strawlab/lagtest-old/README.md

lagtest - How slow is your display?
===================================

This is the source code repository for the
[lagtest](http://lagtest.org) project. The desktop app is in `app/`,
the firmware for the Arduino-based device in in `lagtestino/`, and the
website is in `website/`.
