strawlab/lagtest-old/website/index.md

---
title: home
layout: default
---

# lagtest - How slow is your display?

<table><tr><td>
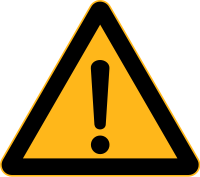
[picture p3: website/assets/img/warning.png]

</td><td>
Warning: lagtest.org is not yet complete, but we're developing in
public. To see our work in progress, check <a href="https://github.com/strawlab/lagtest">our github
repository</a>.
</td></tr></table>

## New displays are slow

Old-style CRT displays may be big and bulky, but there is practically
zero delay between video card output and luminance change on the
screen -- the analog voltages output by the video card directly
control the intensity of the electron beam. With the rise of new
display technologies such as LCDs and DLPs, this has changed for
several reasons (resampling the image and other onboard image
processing, inherent slowness due to the physics of the device, and so
on). The purpose of [lagtest.org](http://lagtest.org) is to let you
measure the latency from a computer program sending a draw command to
the result appearing on your screen.

<table>
  <tr><td align="center">
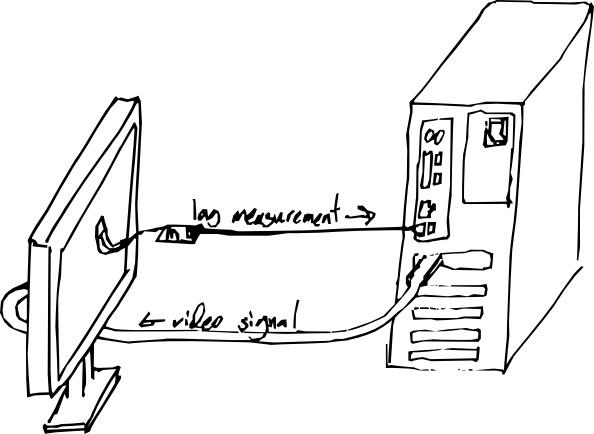
[picture p4: website/assets/img/lag-drawing.png]
    
  </td></tr>
  <tr><td>
    <strong>A simple USB device (based on an <a href="http://www.arduino.cc/">Arduino</a> and a
    photodiode) lets you measure latency from software to photons.</strong>
  </td></tr>
</table>

## How slow is your display?

The [lagtestino](lagtestino) is a USB-connected photodiode. Connect it to your
computer, run the lag-test program, follow the on screen instructions,
and you have your latency estimate.

## To-do list

* Allow logins on the website
* Allow the desktop app to login with some credentials to the website
* Allow the desktop app to upload the gathered data to the website
* Create an interface on the website for querying data (e.g. "select
  display with lowest latency").
* Package and test desktop app for easy running in Windows and Mac OS X
* Rewrite desktop app in C/C++ for a small download size?

<hr>

### Interesting links

[Latency – the sine qua non of AR and VR](http://blogs.valvesoftware.com/abrash/latency-the-sine-qua-non-of-ar-and-vr/)
[Response Time Measurement](http://www.tftcentral.co.uk/articles/response_time.htm)
[An investigation of the test process used to date for determining the response time of an LCD monitor, known as input lag](http://www.prad.de/en/monitore/specials/inputlag/inputlag.html)
[Input Lag Testing](http://www.tftcentral.co.uk/articles/input_lag.htm)
A somewhat insane [method of reducing lag on one particular TV](http://www.youtube.com/watch?v=h2O5wvJTtdo)

### Credits

Initial software development was done in the [Straw
lab](http://strawlab.org) with core funding from [the
IMP](http://www.imp.ac.at). We would also like to thank other software
and services that made this possible with relatively little effort:
Python, numpy, GTK, matplotlib, Arduino, github.
