strawlab/lagtest-old/website/assets/img/lag-drawing-orig.png

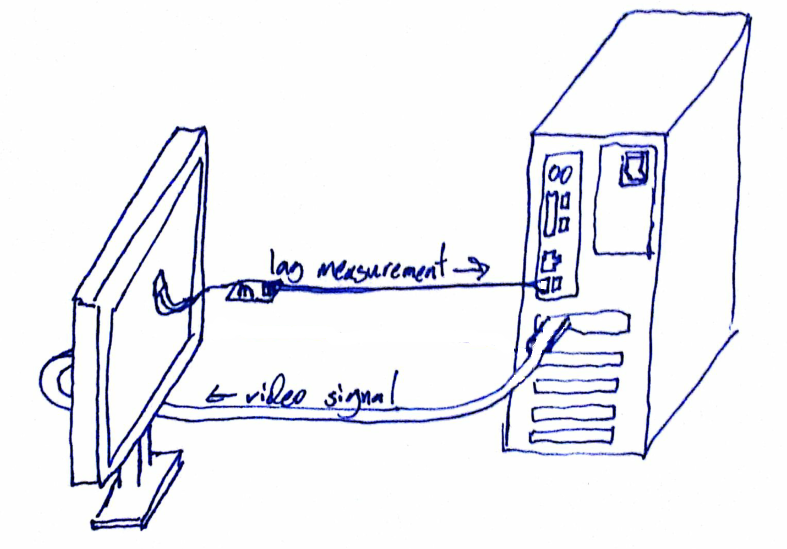
website/assets/img/lag-drawing-orig.png
