strawlab/lagtest-old/(list of files, drawings)

Other design files:
website/assets/other/lagtest.fzz
