strawlab/lagtest-old/qlagtest/src/lagtest.cpp

#include "lagtest.h"

#include <QSettings>
#include <QString>
#include <QComboBox>
#include <QVBoxLayout>
#include <QEventLoop>
#include <QProcess>

#include "timemodel.h"
#include "latencymodel.h"
#include "serialporthandler.h"
#include "window.h"
#include "rs232.h"
#include <QPlainTextEdit>
#include <qapplication.h>

#include <QNetworkAccessManager>
#include <QNetworkReply>
#include <QFileDialog>
#include <QMessageBox>


#include <QDesktopServices>
#include <QJsonDocument>
#include <QJsonArray>
#include <QJsonObject>
#include <QVariantMap>
#include <QAbstractButton>
#include <QFile>
#include <QDir>

LagTest::LagTest(int clockSyncPeriod, int latencyUpdate, int screenFlipPeriod)
{
    this->setupLogWindow();

    this->doNewVersionCheck();

    TimeModel* tm = new TimeModel();    
    //tm.testModelGenerator();

    RingBuffer<screenFlip>* screenFlips = new RingBuffer<screenFlip>(20);
    RingBuffer<clockPair>* adruinoClock = new RingBuffer<clockPair>(100);
    RingBuffer<adcMeasurement>* adcValues = new RingBuffer<adcMeasurement>(20000);

    this->loadSettings();

    //Make user define the serial port
    QString port = settings->value("Adruino/Port").toString();

    qDebug("Creating handler for serial port on %s...", port.toStdString().c_str() );
    // Setup Serial Port Reader
    this->serial = new SerialPortHandler(port, clockSyncPeriod, tm, adruinoClock, adcValues);
    this->lm = new LatencyModel(latencyUpdate, tm, screenFlips, adruinoClock, adcValues);
    this->w = new Window(tm, screenFlips);

    QObject::connect( w, SIGNAL(doReset()), lm, SLOT(reset()) );
    QObject::connect( w, SIGNAL(startMeassurement()), serial, SLOT(start()) );
    QObject::connect( w, SIGNAL(startMeassurement()), lm, SLOT(start()) );
    QObject::connect( w, SIGNAL(generateReport()), this, SLOT( generateReport() ) );
    QObject::connect( w, SIGNAL(flashAdruino()), this, SLOT( recvFlashAdruino() ) );
    QObject::connect( w, SIGNAL(showLogWindow()), this, SLOT( recvShowLogWindow() ) );
    QObject::connect( w, SIGNAL(selectPort()), this, SLOT( recvSelectPort() ) );

    //QObject::connect( &w, &Window::flashAdruino, getAdruinoPort );


    QObject::connect( lm, SIGNAL(signalStableLatency()),        w, SLOT(receiveStableLatency()) );
    QObject::connect( lm, SIGNAL(signalUnstableLatency()),      w, SLOT(receiveUnstableLatency()) );
    QObject::connect( lm, SIGNAL(signalInvalidLatency()),       w, SLOT(receiveInvalidLatency()) );
    QObject::connect( lm, SIGNAL(signalUpdate(LatencyModel*)),  w, SLOT(receiveLatencyUpdate(LatencyModel*)) );
    QObject::connect( lm, SIGNAL(signalNewMeassurementWindow(uint8_t*,double*,double*,flip_type)), w, SLOT(receiveNewMeassurementWindow(uint8_t*,double*,double*,flip_type)) );


    QObject::connect( serial, SIGNAL(sendDebugMsg(QString)),    this, SLOT(recvSerialMsg(QString)) );
    QObject::connect( serial, SIGNAL(sendErrorMsg(QString)),    this, SLOT(recvSerialError(QString)) );

    w->show();
}

LagTest::~LagTest()
{
}

QPlainTextEdit* logWindow = NULL;



void myMessageOutput(QtMsgType type, const QMessageLogContext &context, const QString &msg)
{    
    if( logWindow !=  NULL) {
        logWindow->appendPlainText( msg );
    } else {
        fprintf(stderr, "%s" , msg.toStdString().c_str() );
    }
}

void LagTest::setupLogWindow()
{
    logWindow = new QPlainTextEdit(0);
    logWindow->setWindowTitle( "Log window ");
    logWindow->setCenterOnScroll(true);
    logWindow->setReadOnly(true);
    logWindow->resize( 700 , 500 );
    logWindow->hide();
    qInstallMessageHandler( myMessageOutput );
}

void LagTest::recvShowLogWindow(){
    logWindow->show();
}

void LagTest::recvSerialMsg(QString msg)
{
    QString s;
    s = "SerialPort: ";
    s += msg;
    qDebug( s.toStdString().c_str() );
}

void LagTest::recvSerialError(QString msg)
{
    QString s;
    s = "Error SerialPort: ";
    s += msg;
    qDebug( s.toStdString().c_str() );
}

void LagTest::generateReport()
{
    QString text;
    QString s;
    text.append( "Lagtest - Latency Report\n" );
    text.append( "########################\n" );

    text.append( "\n" );
    text.append( s.sprintf("Average Latency:        %3.2f [ms]\n" , (this->lm->getAvgLatency()/1e6) ) );
    text.append( s.sprintf("Standard deviation:     %3.2f [ms]\n" , this->lm->getAvgLatencySD()/1e6 ) );
    text.append( s.sprintf("Measurement duration:   %3.2f [sec]\n" , this->lm->getMeasurementDuration() / 1e9 ) );

    text.append( "\n" );
    text.append( tr("Display Vendor: XXXXXXX \n") );
    text.append( tr("Display Model:  XXXXXXX \n") );

    text.append( "\n" );
    text.append( tr("Report generated with LagTest v%1 \n").arg( QCoreApplication::applicationVersion() ) );
    text.append( tr("Find out how slow YOUR display is. Check %1 \n").arg("http://lagtest.org") );

    qDebug("Report: \n%s", text.toStdString().c_str());

    QString fileName = QFileDialog::getSaveFileName(0, tr("Save Protocol"), "C:", tr("Text File (*.txt)"));
    QFile f(fileName);
    if( f.open( QIODevice::WriteOnly | QIODevice::Text ) )
    {
        f.write( text.toLocal8Bit() );
    } else {
        QMessageBox::warning(0, tr("Write Error"), tr("Writing Protocol failed!") , QMessageBox::Ok, QMessageBox::NoButton);
    }
    f.close();
}

void LagTest::recvFlashAdruino()
{
    //qDebug("Current path %s" , QCoreApplication::applicationDirPath().toStdString().c_str() );
    programArduino( QCoreApplication::applicationDirPath().append("/tools/avrdude.exe"), QCoreApplication::applicationDirPath().append("/firmware.hex"), this->settings->value("Adruino/Port").toString());
}

void LagTest::recvSelectPort()
{
    QString port = makeUserSelectPort();
    QSettings* settings = new QSettings("lagtest.ini", QSettings::IniFormat);
    settings->setValue("Adruino/Port", port );
    settings->sync();
    delete(settings);
}

void LagTest::doNewVersionCheck()
{    
    QNetworkAccessManager *manager = new QNetworkAccessManager(this);
    connect(manager, SIGNAL(finished(QNetworkReply*)), this, SLOT(recvVersionCheckFinished(QNetworkReply*)));
    manager->get(QNetworkRequest(QUrl("http://version.lagtest.org/latest")));
    //manager->get(QNetworkRequest(QUrl("http://www.google.de/index.html")));
}

void LagTest::recvVersionCheckFinished(QNetworkReply *reply)
{
    if( reply->error() == QNetworkReply::NoError )
    {
        QByteArray d = reply->readAll();
//        QString jraw("{\"version\": \"100.9\", \"changes\": [\"fancy new feature\", \"bugfix\"]}");
//        d = QByteArray(jraw.toStdString().c_str());

        qDebug("Jason parsing of [%s]", d.data());
        QJsonObject jO = QJsonDocument::fromJson( d ).object();

        QString version = jO.value("version").toString();
        QJsonArray changes = jO.value("changes").toArray();
        QString ch1 = changes.at(0).toString();
        QString ch2 = changes.at(1).toString();
        qDebug("version = %s , changes [%s , %s]" , version.toStdString().c_str() , ch1.toStdString().c_str() , ch2.toStdString().c_str() );

        double verNew, verCur;
        int major,minor,bfx;
        sscanf( version.toStdString().c_str() , "%d.%d.%d." , &major, &minor, &bfx);
        verNew = major + (minor/10.0) + (bfx / 100);

        sscanf( QCoreApplication::applicationVersion().toStdString().c_str() , "%d.%d.%d." , &major, &minor, &bfx);
        verCur = major + (minor/10.0) + (bfx / 100);

        //qDebug("Version check: cur [%f] , new [%f]" , verCur, verNew);
        if( verNew > verCur )
        {
            QMessageBox *box = new QMessageBox(QMessageBox::NoIcon, "Version update", tr("New version available! %1 -> %2\n%3\n%4").arg(QCoreApplication::applicationVersion()).arg(version).arg(ch1).arg(ch2) \
                                               ,QMessageBox::Ignore | QMessageBox::Ok);
            box->button(QMessageBox::Ok)->setText("Update");
            int buttonPressed = box->exec();
            if( buttonPressed == QMessageBox::Ok ) {
                QDesktopServices::openUrl(QUrl("http://lagtest.org", QUrl::TolerantMode));
            }
        }

    } else {
        qDebug( "Lagtest version check failed! %s\n " , reply->errorString().toStdString().c_str() );
    }

    reply->deleteLater();
}

std::vector<QString> LagTest::discoverComPorts()
{
    std::vector<int> ports;
    std::vector<QString> portsNames;
    char cbuffer[10];

    qDebug("Discovering Serial Ports ...");

    for(int i = 1; i < 16; i++){    //Only search for ports between COM6-COM16
        if( !RS232_OpenComport(i, 9600) ){
            ports.push_back(i);
            RS232_CloseComport( i );
        }
    }

    #ifdef __linux__
    assert(0 && "No linux implementation");
    #else
        for(std::vector<int>::iterator it = ports.begin(); it != ports.end(); ++it) {
            sprintf(cbuffer, "COM%d", (*it)+1);
            portsNames.push_back( QString( cbuffer ) );
        }
    #endif

    return portsNames;
}

void LagTest::receiveFlashAdruino()
{
    this->settings->beginGroup("Adruino");
    settings->value("port");
}

QString LagTest::makeUserSelectPort()
{    
    //Create a simple QWidget that contains a dropdown list of all serial ports
    QWidget mainWindow;
    QComboBox combo;
    QVBoxLayout layout;
    QEventLoop loop;
    QLabel PortSelectMsg("Select the port adruino is connected to");

    mainWindow.setWindowFlags(Qt::WindowTitleHint );
    PortSelectMsg.setAlignment(Qt::AlignHCenter);
    layout.addWidget( &PortSelectMsg, 0 );
    layout.addWidget( &combo, 0 );
    mainWindow.setLayout( &layout );

    std::vector<QString> ports = discoverComPorts();
    for(std::vector<QString>::iterator it = ports.begin(); it != ports.end(); ++it) {
        //qDebug("Found Port %s" , (*it).toStdString().c_str() );
        combo.addItem(*it);
    }
    QObject::connect(&combo, SIGNAL(activated(QString)), &loop, SLOT( quit() ));

    mainWindow.show();
    loop.exec();    //Wait till the user selects an entry
    mainWindow.close();

    qWarning( "User selected Port %s " , combo.currentText().toStdString().c_str() );
    return combo.currentText();
}

int LagTest::programArduino(QString avrDudePath, QString pathToFirmware, QString port)
{
    qDebug("Trying to flash adruino ...");
    char buffer[300];
    if( port.isEmpty() ){
        port = makeUserSelectPort();
    }

    sprintf(buffer, "-F -v -pm328p -c arduino -b 115200 -P\\\\.\\%s -D -Uflash:w:%s:i", port.toStdString().c_str(), pathToFirmware.toStdString().c_str() );

    QString param(QString::fromLocal8Bit(buffer));
    qDebug("Calling %s with %s" , avrDudePath.toStdString().c_str(), param.toStdString().c_str() );

    QProcess process;    
    process.execute (avrDudePath, param.split(" "));

    if( process.exitCode() == 0){
        qDebug("Flashing Arduino was successful!");
    } else {
        qCritical("Flashing Arduino failed! Error code %d" , process.exitCode());
    }

    // Store this settings for the normal program execution
    QSettings* settings = new QSettings("lagtest.ini", QSettings::IniFormat);
    QDir dir;
    settings->setValue("Adruino/Port", port );
    settings->setValue("Adruino/avrDudePath", dir.relativeFilePath( avrDudePath ) );
    settings->setValue("Adruino/firmwarePath", dir.relativeFilePath( pathToFirmware ) );
    settings->sync();
    delete(settings);

    return process.exitCode();
}

bool LagTest::loadSettings()
{
    this->settings = new QSettings("lagtest.ini", QSettings::IniFormat);

    //If we dont have this setting, or the port is not valid, let the user define a new port
    if( !this->testPort( settings->value("Adruino/Port").toString() ))
    {
        qDebug("Port not valid, query user to specify new one.");
        QString nPort;
        do{
            nPort = makeUserSelectPort();
            if( !this->testPort(nPort) ){
                qCritical("Invalid Port!");
                nPort = "";
            }
        } while( nPort.isEmpty() );
        settings->setValue("Adruino/Port", nPort );
        settings->sync();
    }

    return true;

    //Create entries
    //    settings->beginGroup("Adruino");
    //        settings->setValue("Port", "COM11");
    //        settings->setValue("avrDudePath", "tools/avrdude.exe");
    //        settings->setValue("firmwarePath", "firmware.hex");
    //    settings->endGroup();
    //    settings->sync();
}

bool LagTest::testPort(QString port)
{
    int portIdx = LagTestSerialPortComm::getPortIdx(port);

    if( portIdx < 0)
        return false;

    if( !RS232_OpenComport(portIdx, 9600) ){
        RS232_CloseComport( portIdx );
        return true;
    }
    return false;
}
