strawlab/lagtest-old/qlagtest/src/latencymodel.cpp

#include "latencymodel.h"
#include <limits>

LatencyModel::LatencyModel(int ms_updateRate, TimeModel *tm, RingBuffer<screenFlip> *screenFlips, RingBuffer<clockPair> *clock_storage, RingBuffer<adcMeasurement> *adc_storage)
    : QObject(0),
	tm(tm), screenFlips(screenFlips), clock(clock_storage), adc(adc_storage),
      timer(0),
      latencyCnt(0), flipCnt(0)
{
    qDebug("Creating LatencyModel ...");
    // Setup period update of the model
	this->timer = new QTimer();
    connect( timer, SIGNAL(timeout()), this, SLOT( update() ));    
    this->timer->setInterval(ms_updateRate);
    this->resetHistory();
}

void LatencyModel::start()
{
    QTimer* t = new QTimer();
    t->setSingleShot(true);
    connect(t, SIGNAL(timeout()), this, SLOT( realStart()) );
    t->start(2000); //start one second later
}

void LatencyModel::realStart()
{
    this->measurementStartTime = tm->getCurrentTime();
    qDebug("Starting latency model @%g" , this->measurementStartTime );
    this->screenFlips->reset();
    //qDebug("Screen Flip %d", this->screenFlips->canGet() );
    //this->adc->reset();
    this->resetHistory();
    this->timer->start();
}

void LatencyModel::resetHistory()
{
    qDebug("Reseting Latency Model History ...");
    //Initialize latency history
    for( int i=0; i < LatencyModel::latencyHistorySize; i++)  {
        this->latency[i] = -1.0;
    }

    for( int j=0; j < measurementWindowSize; j++ )
    {
        this->avgAdcWindow[WHITE_TO_BLACK][j] = 0;
        this->avgAdcWindow[BLACK_TO_WHITE][j] = 0;
        this->sampleTimes[j] = 0.0;
    }

    for( int i=0; i < LatencyModel::measurementHistoryLength; i++)
    {
        for( int j=0; j < measurementWindowSize; j++ )
        {
            this->adcData[WHITE_TO_BLACK][i][j] = -1;
            this->adcData[BLACK_TO_WHITE][i][j] = -1;
        }
        emit signalNewMeassurementWindow( this->adcData[WHITE_TO_BLACK][i], this->avgAdcWindow[WHITE_TO_BLACK], this->sampleTimes, WHITE_TO_BLACK );
        emit signalNewMeassurementWindow( this->adcData[BLACK_TO_WHITE][i], this->avgAdcWindow[BLACK_TO_WHITE], this->sampleTimes, BLACK_TO_WHITE );
    } 
    emit signalUpdate(this);

    this->measurementCnter[BLACK_TO_WHITE] = -1;
    this->measurementCnter[WHITE_TO_BLACK] = -1;

    this->nMeasurements[BLACK_TO_WHITE] = 0;
    this->nMeasurements[WHITE_TO_BLACK] = 0;

    this->lastLatency = -1.0;
    this->avgLatency = -1.0;
    this->avgLatencySD = 0.0;
    this->allLatencies.clear();
    this->measurementStartTime = this->tm->getCurrentTime();

}

void LatencyModel::reset()
{
    this->resetHistory();
}

void LatencyModel::update()
{
    double latency;

    //qDebug("Updateing the latency model [%g]", this->tm->getCurrentTime() );

    //Read all new clock pairs and use them to update the time model
    clockPair cp;
    while(this->clock->canGet()){
        this->clock->get(&cp);
        this->tm->update(cp);
    }

    latency = -1.0;

    while( this->screenFlips->canGet() )
    {
        this->screenFlips->get(&(this->flips[this->flipCnt]) );

        if( this->findMeasurementWindow( this->flips[this->flipCnt] ) )
        {
            latency = this->calculateLatency( );
            //qDebug("Latency [%g]", latency);

            this->addLatency( latency );
            flipCnt = (flipCnt+1) % flipHistorySize;
        } else {
            //Leave this flip for the next time arround
            this->screenFlips->unget();
            break;
        }
    }      

    if( latency != -1.0 )
    {        
        if( this->isStable( this->latencyStableSize ) ){
            emit signalStableLatency();
        } else {
            emit signalUnstableLatency();
        }
        emit signalUpdate(this);
    }
}

void LatencyModel::addLatency(double newLatency)
{
    double t;
    latencyCnt = (latencyCnt+1) % latencyHistorySize;
    this->latency[this->latencyCnt] = newLatency;

    if( ( this->nMeasurements[BLACK_TO_WHITE]+this->nMeasurements[WHITE_TO_BLACK]) < latencyHistorySize )
        return;

    this->lastLatency = newLatency;
    t = 0;
    for(int i=0; i < latencyHistorySize; i++){
        t += latency[i];
    }
    this->avgLatency = t / latencyHistorySize;

    t = 0;
    for(int i=0; i < latencyHistorySize; i++){
        t += sqrt( (latency[i]-avgLatency) * (latency[i]-avgLatency) );
    }

    this->avgLatencySD = t / latencyHistorySize;

    this->allLatencies.push_back( newLatency );
}

double LatencyModel::calculateLatency()
{
    //Calculate mean values
    int j, idx;
    double latency;

    if( this->detectdisplacedSensor() )
    {
        emit signalInvalidLatency();
        return -1;
    }

    this->createAvgWindow();

    idx = -1;
    for( j=0; j < measurementWindowSize; j++ )
    {
        if( avgAdcWindow[WHITE_TO_BLACK][j] < avgAdcWindow[BLACK_TO_WHITE][j]){
            idx = j;
            //qDebug("Found a crossofer at idx %d", idx);
            break;
        }
    }

    if( (idx == 0) || (idx==measurementWindowSize) )
    {
        qWarning("Could not detect crossover!");
        latency = -1;
        emit signalInvalidLatency();
    } else {
        latency = this->sampleTimes[idx];
    }

    return latency;
}

void LatencyModel::createAvgWindow()
{
    int i,j,n[2];
    //char buffer[2000];

    n[WHITE_TO_BLACK] = nMeasurements[WHITE_TO_BLACK];
    n[BLACK_TO_WHITE] = nMeasurements[BLACK_TO_WHITE];

    if( n[WHITE_TO_BLACK] > measurementHistoryLength)
        n[WHITE_TO_BLACK] = measurementHistoryLength;

    if( n[BLACK_TO_WHITE] > measurementHistoryLength)
        n[BLACK_TO_WHITE] = measurementHistoryLength;

    for(i = 0; i < measurementWindowSize; i++){
        this->avgAdcWindow[WHITE_TO_BLACK][i] = 0.0;
        this->avgAdcWindow[BLACK_TO_WHITE][i] = 0.0;
    }

    //char buffer[2000];

    for( i=0; i < measurementHistoryLength; i++)
    {
        for( j=0; j < measurementWindowSize; j++ )
        {
            if(n[WHITE_TO_BLACK] > i) {
                avgAdcWindow[WHITE_TO_BLACK][j] += this->adcData[WHITE_TO_BLACK][i][j];                    
            }

            if(n[BLACK_TO_WHITE] > i) {
                avgAdcWindow[BLACK_TO_WHITE][j] += this->adcData[BLACK_TO_WHITE][i][j];
            }
        }

//        buffer[0] = 0;
//        sprintf(buffer,"W2B Sample [%d]\n", i);
//        for(int k = 0; k < measurementWindowSize; k++){
//            sprintf( &buffer[strlen(buffer)], " [%d] ", (this->adcData[WHITE_TO_BLACK][i][k]) );
//        }
//        qDebug(buffer);

//        buffer[0] = 0;
//        sprintf(buffer,"B2W Sample [%d]\n", i);
//        for(int k = 0; k < measurementWindowSize; k++){
//            sprintf( &buffer[strlen(buffer)], " [%d] ", (this->adcData[BLACK_TO_WHITE][i][k]) );
//        }
//        qDebug(buffer);
//        qDebug("#############");

    }

    for( j=0; j < measurementWindowSize; j++ )
    {
        avgAdcWindow[WHITE_TO_BLACK][j] = avgAdcWindow[WHITE_TO_BLACK][j] / n[WHITE_TO_BLACK];
        avgAdcWindow[BLACK_TO_WHITE][j] = avgAdcWindow[BLACK_TO_WHITE][j] / n[BLACK_TO_WHITE];
    }

//    buffer[0] = 0;
//    sprintf(buffer,"Avg Window n = [%d / %d]\n", n[0], n[1]);
//    for(i = 0; i < measurementWindowSize; i++){
//        sprintf( &buffer[strlen(buffer)], " [%g] ", (this->avgAdcWindow[WHITE_TO_BLACK][i]) );
//    }
//    qDebug(buffer);

}


//Calculate the avg and standart derivation for the last measurement window
bool LatencyModel::detectdisplacedSensor()
{
    int j;
    double windowAVG[2] = {0, 0};
    double windowSTD[2] = {0, 0};
    double t;

    for( j=0; j < measurementWindowSize; j++ )
    {
        windowAVG[WHITE_TO_BLACK] += this->adcData[WHITE_TO_BLACK][this->measurementCnter[WHITE_TO_BLACK]][j];
        windowAVG[BLACK_TO_WHITE] += this->adcData[BLACK_TO_WHITE][this->measurementCnter[BLACK_TO_WHITE]][j];
    }
    windowAVG[WHITE_TO_BLACK] = windowAVG[WHITE_TO_BLACK] / (double) measurementWindowSize;
    windowAVG[BLACK_TO_WHITE] = windowAVG[BLACK_TO_WHITE] / (double) measurementWindowSize;

    for( j=0; j < measurementWindowSize; j++ )
    {
        t = windowAVG[WHITE_TO_BLACK] - this->adcData[WHITE_TO_BLACK][this->measurementCnter[WHITE_TO_BLACK]][j];
        windowSTD[WHITE_TO_BLACK] += sqrt( t*t );

        t = windowAVG[BLACK_TO_WHITE] - this->adcData[BLACK_TO_WHITE][this->measurementCnter[BLACK_TO_WHITE]][j];
        windowSTD[BLACK_TO_WHITE] += sqrt( t*t );
    }

    //qDebug("Analysis W2B: [%g / %g] | B2W: [%g / %g]" , windowSTD[WHITE_TO_BLACK],windowAVG[WHITE_TO_BLACK], windowSTD[BLACK_TO_WHITE],windowAVG[BLACK_TO_WHITE]);
    if( (windowSTD[WHITE_TO_BLACK] < 2*windowAVG[WHITE_TO_BLACK]) || (windowSTD[BLACK_TO_WHITE] < 2*windowAVG[BLACK_TO_WHITE]) )
    {
        qDebug("Too little difference in the measurement values ... W2B: [%g / %g] | B2W: [%g / %g]" , windowSTD[WHITE_TO_BLACK],windowAVG[WHITE_TO_BLACK], windowSTD[BLACK_TO_WHITE],windowAVG[BLACK_TO_WHITE]);
        return true;
    } else {
        return false;
    }
}

bool LatencyModel::findMeasurementWindow(screenFlip sf )
{   
    bool found = false;
    adcMeasurement s;

    //qDebug("Trying to find a flip at %g", sf.local);
    //Consume all adc sample values till we get one taken after the flip
    while( !found && this->adc->canGet())
    {
        this->adc->get(&s);

        //last entry in the ringbuffer is the sample closest in time to the screen flip
        if( this->tm->toLocalTime(s) > sf.local ){
            found = true;
            //qDebug("For flip at %g using measurements starting from %g" , sf.local, this->tm->toLocalTime(s));
        }
    }

    if( !found || (this->adc->unread() < measurementWindowSize) )
    {   //Could not find a sample close to the screen flip
        qWarning("Not enought adc sample data!");
        found = false;
    } else {
        //The WindowSize Previous elements in the adc ringbuffer are part of this sample window
        int i;
        adcMeasurement tsample;

        this->nMeasurements[sf.type] ++;
        this->measurementCnter[ sf.type ] = (this->measurementCnter[ sf.type ]+1) % measurementHistoryLength;

        this->adcData[sf.type][this->measurementCnter[sf.type]][0] = s.adc;
        this->sampleTimes[0] = this->tm->toLocalTime( s ) - sf.local;

        for(i=1; i < measurementWindowSize; i++){
            if( this->adc->get( &tsample  ) )
            {
                this->adcData[sf.type][this->measurementCnter[sf.type]][i] = tsample.adc;
                this->sampleTimes[i] = this->tm->toLocalTime( tsample ) - sf.local;
                //qDebug("E: %g, T: %g, D: %d", tsample.adruino_epoch, tsample.adruino_ticks, tsample.adc);
            } else {
                qCritical("Not enough data in the ADC ringbuffer");
            }

        }
        //if( nMeasurements[sf.type] > measurementHistoryLength ){
        emit signalNewMeassurementWindow( this->adcData[sf.type][this->measurementCnter[sf.type]], this->avgAdcWindow[sf.type], this->sampleTimes, sf.type );
        //}
    }

//    char buffer[10000];
//    buffer[0] = 0;
//    sprintf(buffer," %s Measurement Window for flip %g\n" , (sf.type == BLACK_TO_WHITE)?"B2W":"W2B", sf.local);
//    for(int k = 0; k < measurementWindowSize; k++){
//        sprintf( &buffer[strlen(buffer)], " [%d] ", (adcData[sf.type][this->measurementCnter[sf.type]][k]) );
//    }
//    qDebug(buffer);

//    char buffer[10000];
//    buffer[0] = 0;
//    sprintf(buffer,"Timetable of adc Sample\n");
//    for(int k = 0; k < measurementWindowSize; k++){
//        sprintf( &buffer[strlen(buffer)], " [%g] ", (this->sampleTimes[k]) );
//    }
//    qDebug(buffer);

    return found;
}

bool LatencyModel::isStable(int stablePeriod)
{
    double diff;
    double t;
    double mean;
    bool isStable = false;
    t = 0;
    int prev;

    //If the last 3 latency values dont differ in more than 10% the result is stable
    mean = 0;
    prev = this->latencyCnt;
    isStable = true;
    for(int i = 0; i < stablePeriod; i++)
    {
        prev = (prev == 0) ? latencyHistorySize-1 : prev-1 ;
        t = this->latency[prev];

        if( mean != 0)
        {
            diff = sqrt( (t-mean)*(t-mean) );
            if( diff > 0.1*mean ){
                isStable = false;
                break;
            } else {
                mean = ( mean + t ) / 2.0;
            }
        } else {
            mean = t;
        }
    }

    return isStable;
}
