strawlab/lagtest-old/(commit log)

2012-07-23 towards a working ADC
2012-07-24 rename for compatibility with Arduino IDE
2012-07-24 now compiles in Arduino IDE
2012-07-24 switch to ttyUSB0 as found on Arduino Nano
2012-07-24 Revert "now compiles in Arduino IDE"
    This reverts commit 67f30450e2fc977c13d6806e2988fa9ee8266ff9.
    [lagtestino.ino]
2012-07-24 build in Arduino IDE
2012-07-24 allow CLI Makefile to work on Nano by actually specifying correct board
2012-07-24 remove LED debug stuff
2012-07-24 failed attempt to LP filter data to reasonableness from DLPs
2012-07-25 rename Makefile for specific board
2012-07-25 perform pseudo-antialiasing by doing high frequency ADC
2012-07-26 link to schematic on circuitlab
2012-07-30 increase sample rate returned to computer
2012-08-31 add makefile for leonardo board
2012-08-31 firmware: switch LED with display
2012-08-31 lag-test: print when version check complete
2012-09-03 add ability to add addtional lag (for ground-truthing)
2012-10-21 add image of Taos detector and cable
2012-10-21 add Fritzing source to make image (not functional as a real Fritzing file)
    [lagtest.fzz]
2012-10-22 app: blink at 2Hz
2012-10-22 app: better error reporting when Arduino not found
2012-10-22 app: replace print statements with GUI label
2012-10-23 app: start and run without detecting USB device
2012-10-23 app: make fake data when no USB device connected
2013-01-21 arduino-mk 0.10.2 doesn't need BOARD_TAG
2013-05-22 Second alpha version
    Contains a first simple but complete gui. Implements the same algorithm
    as the previous lagtest. Detects misplaced light sensor.
2013-05-23 Fixing compilation under linux
    [lagtestserialportcomm.h, latencymodel.cpp, latencymodel.h, main.cpp, window.cpp, window.h]
2013-06-07 Fixing compilation for linux
    [main.cpp, ringbuffer.hpp, serialporthandler.cpp, window.cpp]
2013-06-10 Resolved problems concerning low window. Closing milestone for first beta
    [lagtest.cpp, lagtest.h, main.cpp, serialporthandler.cpp, serialporthandler.h, window.cpp, window.h]
2013-06-10 Fixing additional log window problems and removing console window under windows.
    [lagtest.cpp, lagtest.h, serialporthandler.cpp, serialporthandler.h, window.cpp]
2013-06-13 Improving installer. User can select port from gui. Fixing smaller bugs.
    [lagtest.cpp, lagtest.h, main.cpp, serialporthandler.cpp, window.cpp, window.h]
